DrNotThatEvil/nevil_sbc/hardware/nevil_sbc_rev0/nevil_sbc_rev0.kicad_pcb

## KiCad design hardware/nevil_sbc_rev0/nevil_sbc_rev0.kicad_pcb (2022-11-04)

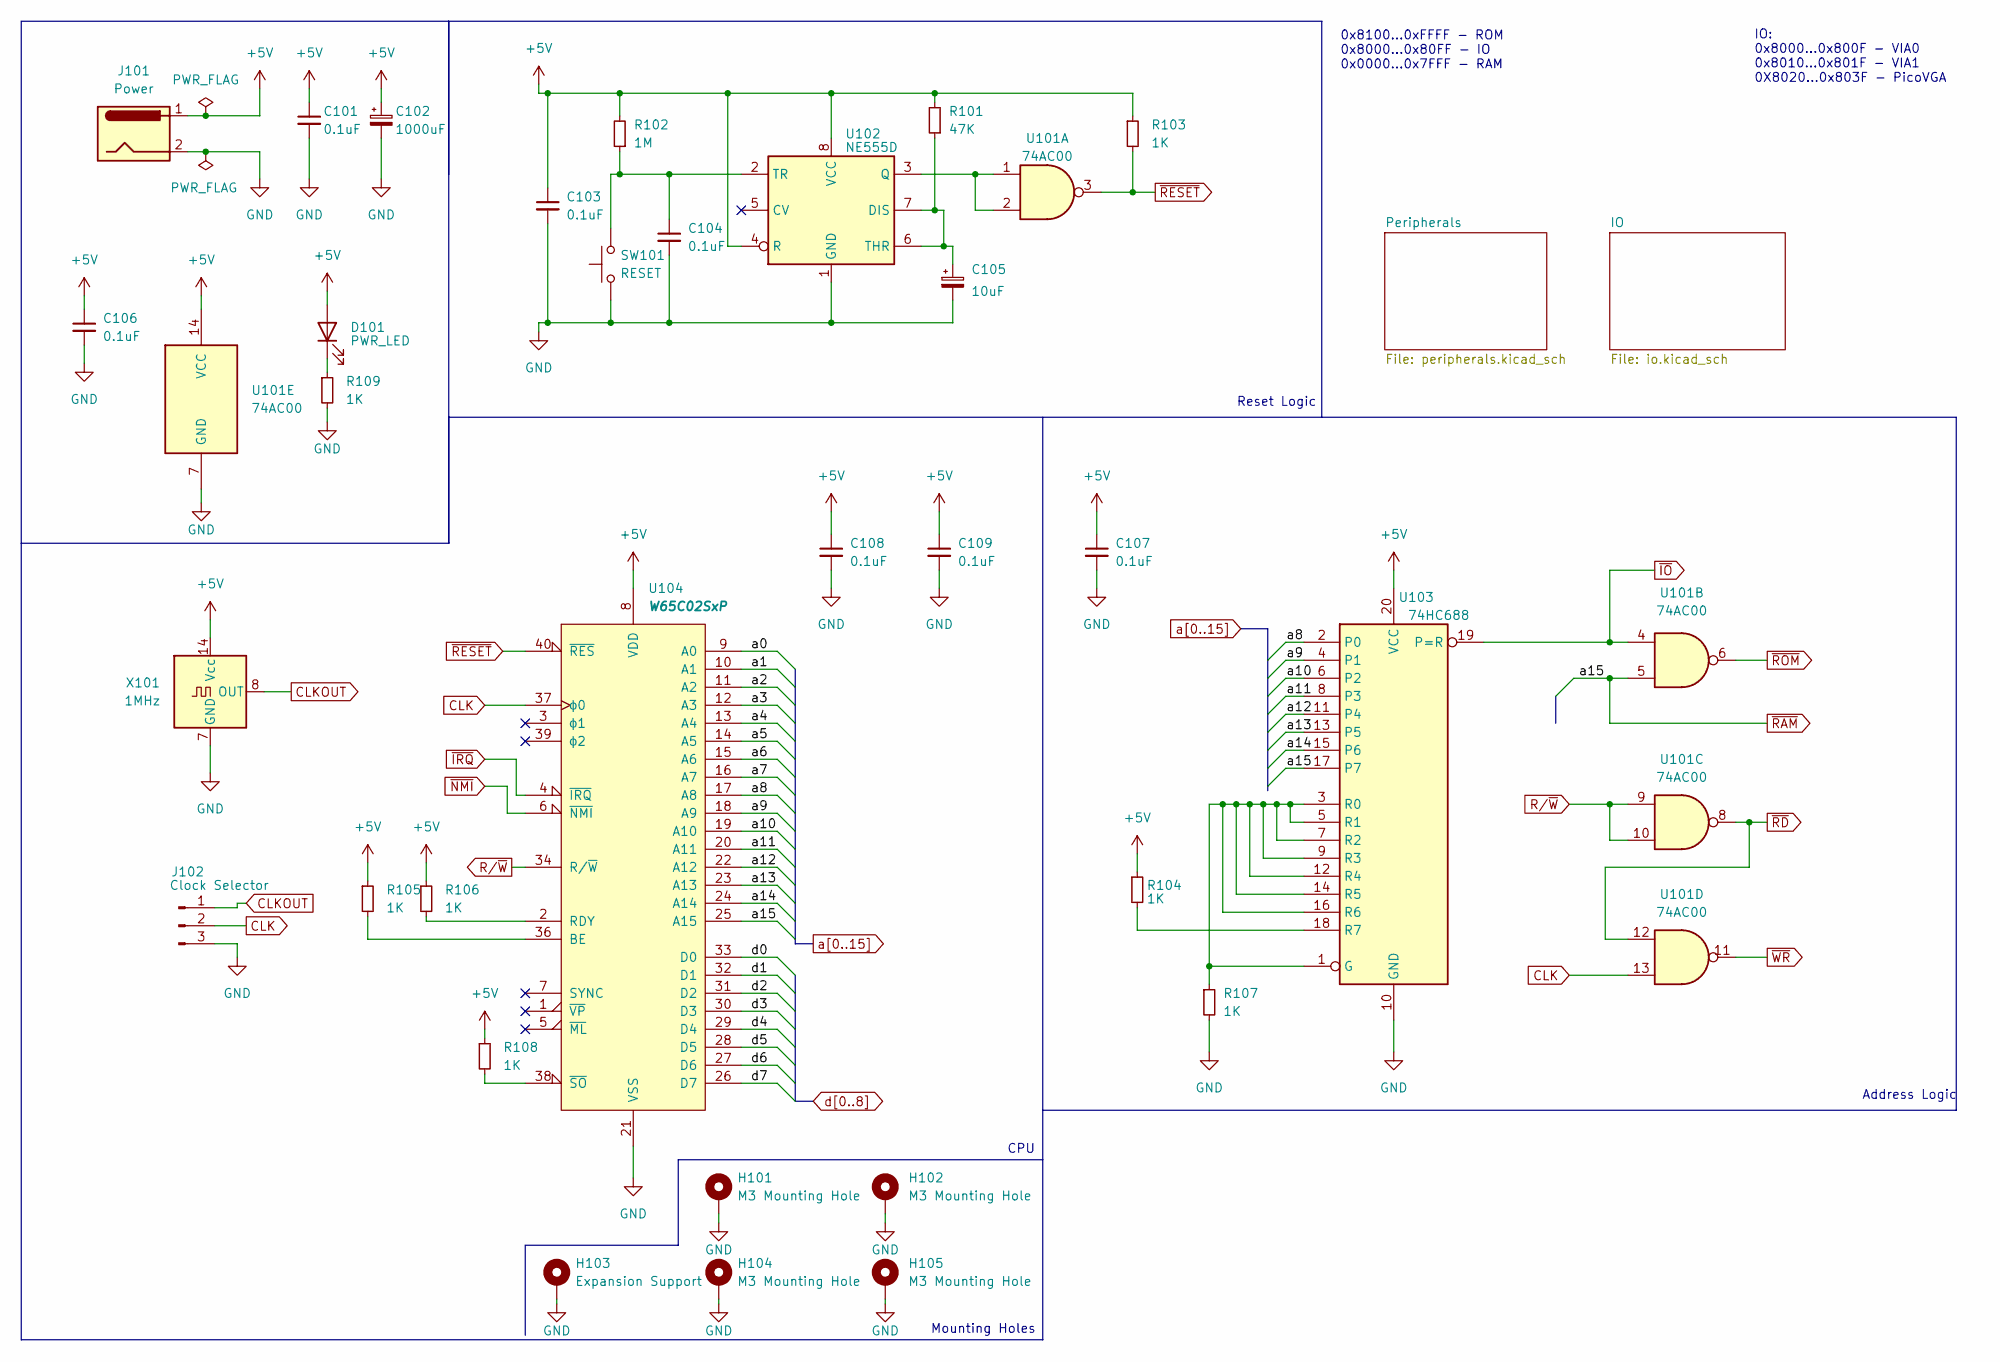
[picture p1: schematic nevil_sbc_rev0.kicad_sch]

Parts:
C101, C103, C104, C106, C107, C108, C109: 0.1uF; C_Disc_D5.0mm_W2.5mm_P5.00mm
C102: 1000uF; CP_Radial_D10.0mm_P5.00mm
C105: 10uF; CP_Radial_D5.0mm_P2.00mm
D101: PWR_LED; LED_D3.0mm
H101, H102, H104, H105: M3 Mounting Hole; MountingHole_3.2mm_M3_Pad
H103: Expansion Support; MountingHole_3.2mm_M3_Pad
J101: Power; C9743-CCRNB001R
J102: Clock Selector; PinHeader_1x03_P2.54mm_Vertical
R101: 47K; R_Axial_DIN0204_L3.6mm_D1.6mm_P7.62mm_Horizontal
R102: 1M; R_Axial_DIN0204_L3.6mm_D1.6mm_P7.62mm_Horizontal
R103, R104, R105, R106, R107, R108, R109: 1K; R_Axial_DIN0204_L3.6mm_D1.6mm_P7.62mm_Horizontal
SW101: RESET; SW_PUSH_6mm
U101: 74AC00; DIP-14_W7.62mm_Socket_LongPads
U102: NE555D; SO-8_5.3x6.2mm_P1.27mm
U103: 74HC688; DIP-20_W7.62mm_Socket_LongPads
U104: W65C02SxP; DIP-40_W15.24mm_Socket_LongPads
X101: 1MHz; DIP-14_W7.62mm_Socket_LongPads

Connections:
+5V: C101.1, C102.1, C103.1, C106.1, C107.1, C108.1, C109.1, D101.2 (A), J101.1, R101.2, R102.2, R103.1, R104.1, R105.1, R106.1, R108.1, U101.14 (VCC), U102.4 (R), U102.8 (VCC), U103.20 (VCC), U104.8 (VDD), X101.14 (Vcc); also elsewhere on the board
CLK: J102.2, U101.13, U104.37 (ϕ0); also elsewhere on the board
CLKOUT: J102.1, X101.8 (OUT)
GND: C101.2, C102.2, C103.2, C104.2, C105.2, C106.2, C107.2, C108.2, C109.2, H101.1, H102.1, H103.1, H104.1, H105.1, J101.2, J102.3, R107.2, R109.2, SW101.1, U101.7 (GND), U102.1 (GND), U103.10 (GND), U104.21 (VSS), X101.7 (GND); also elsewhere on the board
unnamed: C104.1, R102.1, SW101.2, U102.2 (TR)
unnamed: C105.1, R101.1, U102.6 (THR), U102.7 (DIS)
unnamed: D101.1 (K), R109.1
unnamed: R104.2, U103.18 (R7)
unnamed: R105.2, U104.36 (BE)
unnamed: R106.2, U104.2 (RDY)
unnamed: R107.1, U103.1 (G), U103.3 (R0), U103.5 (R1), U103.7 (R2), U103.9 (R3), U103.12 (R4), U103.14 (R5), U103.16 (R6)
unnamed: R108.2, U104.38 (~SO)
unnamed: U101.1, U101.2, U102.3 (Q)
R/~W: U101.9, U101.10, U104.34 (R/~W); also elsewhere on the board
a0: U104.9 (A0); also elsewhere on the board
a1: U104.10 (A1); also elsewhere on the board
a2: U104.11 (A2); also elsewhere on the board
a3: U104.12 (A3); also elsewhere on the board
a4: U104.13 (A4); also elsewhere on the board
a5: U104.14 (A5); also elsewhere on the board
a6: U104.15 (A6); also elsewhere on the board
a7: U104.16 (A7); also elsewhere on the board
a8: U103.2 (P0), U104.17 (A8); also elsewhere on the board
a9: U103.4 (P1), U104.18 (A9); also elsewhere on the board
a10: U103.6 (P2), U104.19 (A10); also elsewhere on the board
a11: U103.8 (P3), U104.20 (A11); also elsewhere on the board
a12: U103.11 (P4), U104.22 (A12); also elsewhere on the board
a13: U103.13 (P5), U104.23 (A13); also elsewhere on the board
a14: U103.15 (P6), U104.24 (A14); also elsewhere on the board
d0: U104.33 (D0); also elsewhere on the board
d1: U104.32 (D1); also elsewhere on the board
d2: U104.31 (D2); also elsewhere on the board
d3: U104.30 (D3); also elsewhere on the board
d4: U104.29 (D4); also elsewhere on the board
d5: U104.28 (D5); also elsewhere on the board
d6: U104.27 (D6); also elsewhere on the board
d7: U104.26 (D7); also elsewhere on the board
~IO: U101.4, U103.19 (P=R); also elsewhere on the board
~IRQ: U104.4 (~IRQ); also elsewhere on the board
~NMI: U104.6 (~NMI)
~RAM: U101.5, U103.17 (P7), U104.25 (A15); also elsewhere on the board
~RD: U101.8, U101.12; also elsewhere on the board
~RESET: R103.2, U101.3, U104.40 (~RES); also elsewhere on the board
~ROM: U101.6; also elsewhere on the board
~WR: U101.11; also elsewhere on the board

Notes on the sheet:
CPU
Address Logic
Reset Logic
0x8100...0xFFFF - ROM 0x8000...0x80FF - IO 0x0000...0x7FFF - RAM
IO: 0x8000...0x800F - VIA0 0x8010...0x801F - VIA1 0X8020...0x803F - PicoVGA
Mounting Holes

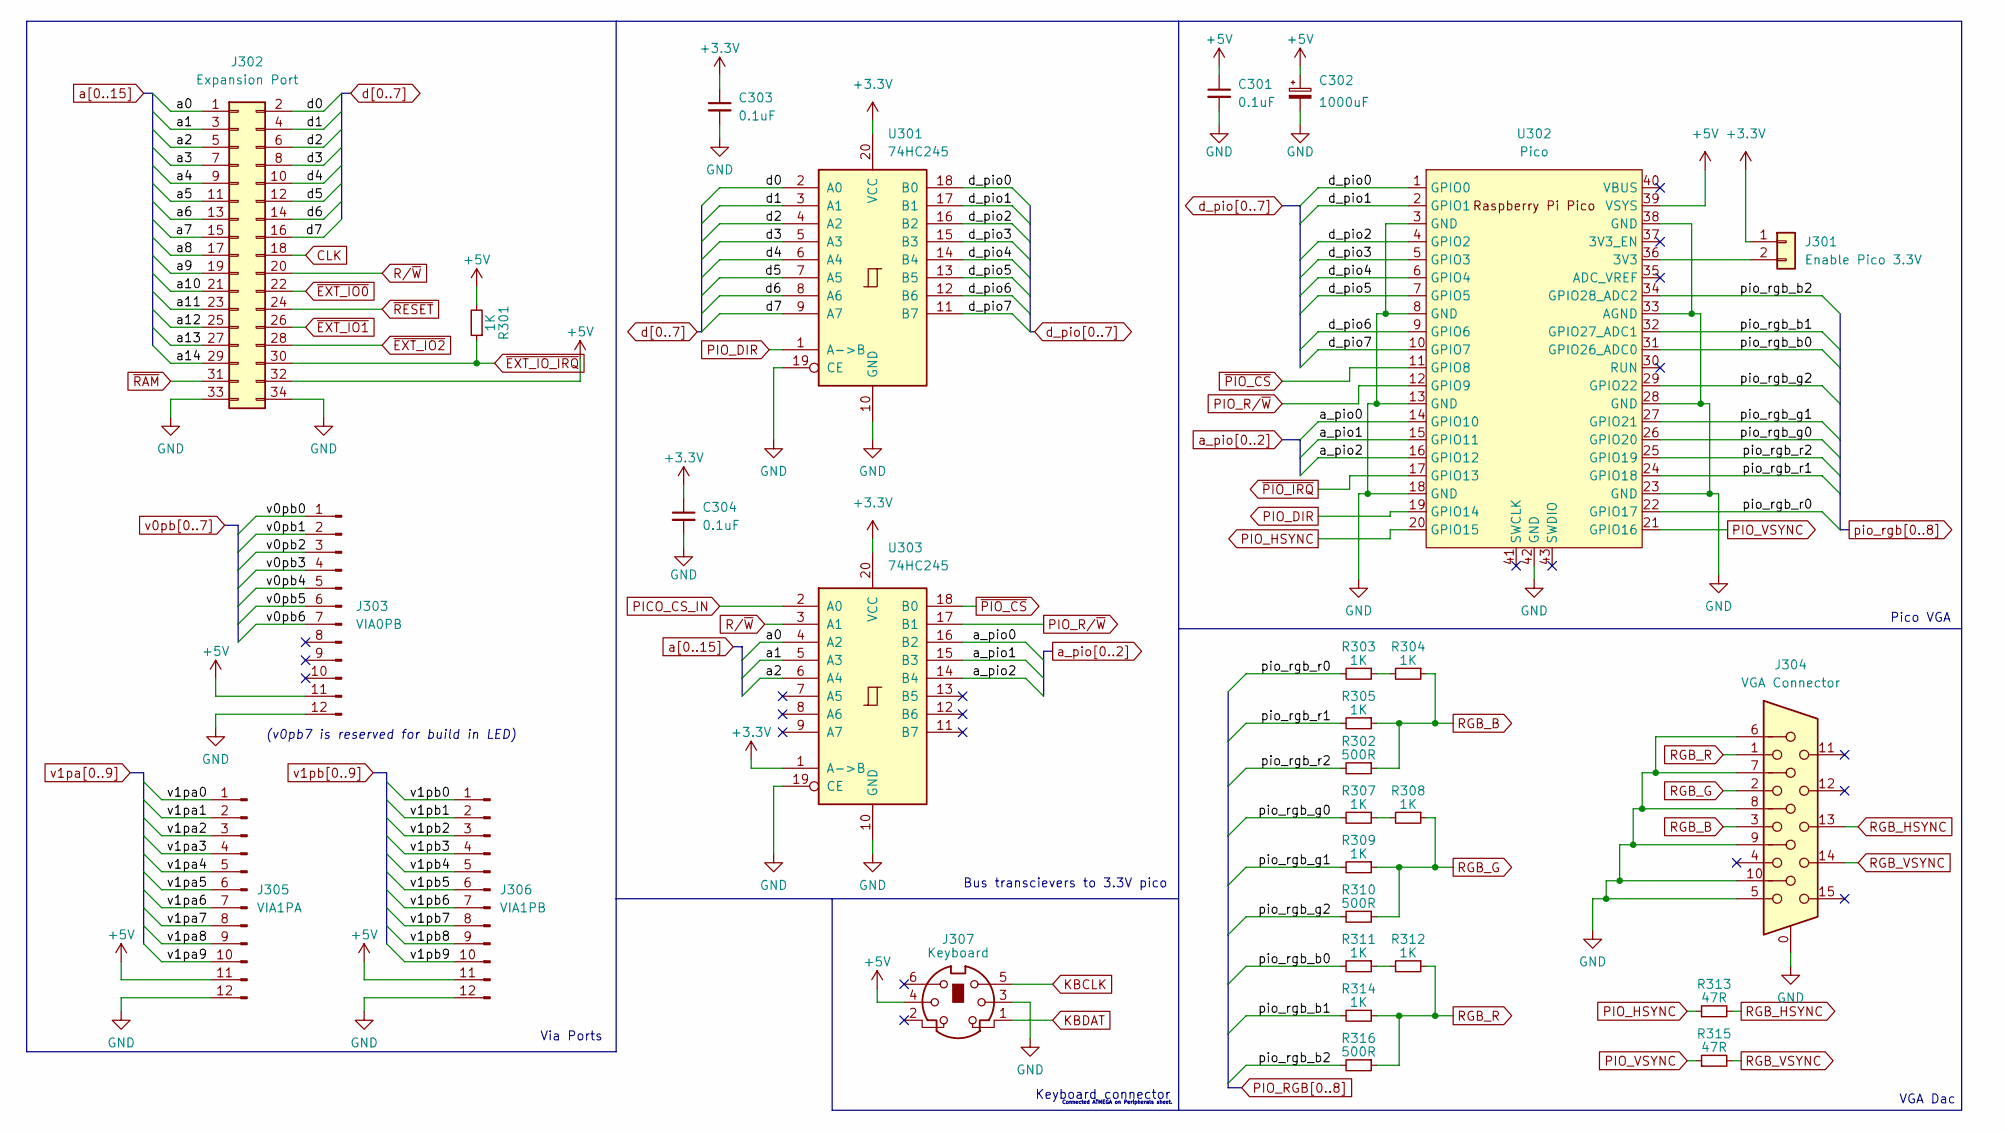
[picture p2: schematic io.kicad_sch]

Parts:
C301, C303, C304: 0.1uF; C_Disc_D5.0mm_W2.5mm_P5.00mm
C302: 1000uF; CP_Radial_D10.0mm_P5.00mm
J301: Enable Pico 3.3V; PinHeader_1x02_P2.54mm_Vertical
J302: Expansion Port; PinHeader_2x17_P2.54mm_Vertical
J303: VIA0PB; PinHeader_1x12_P2.54mm_Vertical
J304: VGA Connector; DSUB-15-HD_Female_Horizontal_P2.29x1.98mm_EdgePinOffset8.35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
J305: VIA1PA; PinHeader_1x12_P2.54mm_Vertical
J306: VIA1PB; PinHeader_1x12_P2.54mm_Vertical
J307: Keyboard; TM 0508 A_6
R301, R303, R304, R305, R307, R308, R309, R311, R312, R314: 1K; R_Axial_DIN0204_L3.6mm_D1.6mm_P7.62mm_Horizontal
R302, R310, R316: 500R; R_Axial_DIN0204_L3.6mm_D1.6mm_P7.62mm_Horizontal
R313, R315: 47R; R_Axial_DIN0204_L3.6mm_D1.6mm_P7.62mm_Horizontal
U301, U303: 74HC245; DIP-20_W7.62mm_Socket_LongPads
U302: Pico; RPi_Pico_SMD_TH

Connections:
+3.3V: C303.1, C304.1, J301.1, U301.20 (VCC), U303.1 (A->B), U303.20 (VCC)
+5V: C301.1, C302.1, J302.32, J303.11, J305.11, J306.11, J307.4, R301.2, U302.39 (VSYS); also elsewhere on the board
/IO/pio_rgb_b0: R311.2, U302.31 (GPIO26_ADC0)
/IO/pio_rgb_b1: R314.2, U302.32 (GPIO27_ADC1)
/IO/pio_rgb_b2: R316.2, U302.34 (GPIO28_ADC2)
/IO/pio_rgb_g0: R307.2, U302.26 (GPIO20)
/IO/pio_rgb_g1: R309.2, U302.27 (GPIO21)
/IO/pio_rgb_g2: R310.2, U302.29 (GPIO22)
/IO/pio_rgb_r0: R303.2, U302.22 (GPIO17)
/IO/pio_rgb_r1: R305.2, U302.24 (GPIO18)
/IO/pio_rgb_r2: R302.2, U302.25 (GPIO19)
CLK: J302.18; also elsewhere on the board
GND: C301.2, C302.2, C303.2, C304.2, J302.33, J302.34, J303.12, J304.0, J304.5, J304.6, J304.7, J304.8, J304.9, J304.10, J305.12, J306.12, J307.3, U301.10 (GND), U301.19 (CE), U302.3 (GND), U302.8 (GND), U302.13 (GND), U302.18 (GND), U302.23 (GND), U302.28 (GND), U302.33 (AGND), U302.38 (GND), U302.42 (GND), U303.10 (GND), U303.19 (CE); also elsewhere on the board
KBCLK: J307.5; also elsewhere on the board
KBDAT: J307.1; also elsewhere on the board
unnamed: J301.2, U302.36 (3V3)
unnamed: R303.1, R304.2
unnamed: R307.1, R308.2
unnamed: R311.1, R312.2
PICO_CS_IN: U303.2 (A0); also elsewhere on the board
PIO_DIR: U301.1 (A->B), U302.19 (GPIO14)
PIO_HSYNC: R313.1, U302.20 (GPIO15)
PIO_R/~W: U302.12 (GPIO9), U303.17 (B1)
PIO_VSYNC: R315.1, U302.21 (GPIO16)
RGB_B: J304.3, R302.1, R304.1, R305.1
RGB_G: J304.2, R308.1, R309.1, R310.1
RGB_HSYNC: J304.13, R313.2
RGB_R: J304.1, R312.1, R314.1, R316.1
RGB_VSYNC: J304.14, R315.2
R/~W: J302.20, U303.3 (A1); also elsewhere on the board
a0: J302.1, U303.4 (A2); also elsewhere on the board
a1: J302.3, U303.5 (A3); also elsewhere on the board
a2: J302.5, U303.6 (A4); also elsewhere on the board
a3: J302.7; also elsewhere on the board
a4: J302.9; also elsewhere on the board
a5: J302.11; also elsewhere on the board
a6: J302.13; also elsewhere on the board
a7: J302.15; also elsewhere on the board
a8: J302.17; also elsewhere on the board
a9: J302.19; also elsewhere on the board
a10: J302.21; also elsewhere on the board
a11: J302.23; also elsewhere on the board
a12: J302.25; also elsewhere on the board
a13: J302.27; also elsewhere on the board
a14: J302.29; also elsewhere on the board
a_pio0: U302.14 (GPIO10), U303.16 (B2)
a_pio1: U302.15 (GPIO11), U303.15 (B3)
a_pio2: U302.16 (GPIO12), U303.14 (B4)
d0: J302.2, U301.2 (A0); also elsewhere on the board
d1: J302.4, U301.3 (A1); also elsewhere on the board
d2: J302.6, U301.4 (A2); also elsewhere on the board
d3: J302.8, U301.5 (A3); also elsewhere on the board
d4: J302.10, U301.6 (A4); also elsewhere on the board
d5: J302.12, U301.7 (A5); also elsewhere on the board
d6: J302.14, U301.8 (A6); also elsewhere on the board
d7: J302.16, U301.9 (A7); also elsewhere on the board
d_pio0: U301.18 (B0), U302.1 (GPIO0)
d_pio1: U301.17 (B1), U302.2 (GPIO1)
d_pio2: U301.16 (B2), U302.4 (GPIO2)
d_pio3: U301.15 (B3), U302.5 (GPIO3)
d_pio4: U301.14 (B4), U302.6 (GPIO4)
d_pio5: U301.13 (B5), U302.7 (GPIO5)
d_pio6: U301.12 (B6), U302.9 (GPIO6)
d_pio7: U301.11 (B7), U302.10 (GPIO7)
v0pb0: J303.1; also elsewhere on the board
v0pb1: J303.2; also elsewhere on the board
v0pb2: J303.3; also elsewhere on the board
v0pb3: J303.4; also elsewhere on the board
v0pb4: J303.5; also elsewhere on the board
v0pb5: J303.6; also elsewhere on the board
v0pb6: J303.7; also elsewhere on the board
v1pa0: J305.1; also elsewhere on the board
v1pa1: J305.2; also elsewhere on the board
v1pa2: J305.3; also elsewhere on the board
v1pa3: J305.4; also elsewhere on the board
v1pa4: J305.5; also elsewhere on the board
v1pa5: J305.6; also elsewhere on the board
v1pa6: J305.7; also elsewhere on the board
v1pa7: J305.8; also elsewhere on the board
v1pa8: J305.9; also elsewhere on the board
v1pa9: J305.10; also elsewhere on the board
v1pb0: J306.1; also elsewhere on the board
v1pb1: J306.2; also elsewhere on the board
v1pb2: J306.3; also elsewhere on the board
v1pb3: J306.4; also elsewhere on the board
v1pb4: J306.5; also elsewhere on the board
v1pb5: J306.6; also elsewhere on the board
v1pb6: J306.7; also elsewhere on the board
v1pb7: J306.8; also elsewhere on the board
v1pb8: J306.9; also elsewhere on the board
v1pb9: J306.10; also elsewhere on the board
~EXT_IO0: J302.22; also elsewhere on the board
~EXT_IO1: J302.26; also elsewhere on the board
~EXT_IO2: J302.28; also elsewhere on the board
~EXT_IO_IRQ: J302.30, R301.1; also elsewhere on the board
~PIO_CS: U302.11 (GPIO8), U303.18 (B0)
~PIO_IRQ: U302.17 (GPIO13)
~RAM: J302.31; also elsewhere on the board
~RESET: J302.24; also elsewhere on the board

Notes on the sheet:
Bus transcievers to 3.3V pico
VGA Dac
Connected ATMEGA on Peripherals sheet.
Via Ports
Keyboard connector
Pico VGA
(v0pb7 is reserved for build in LED)

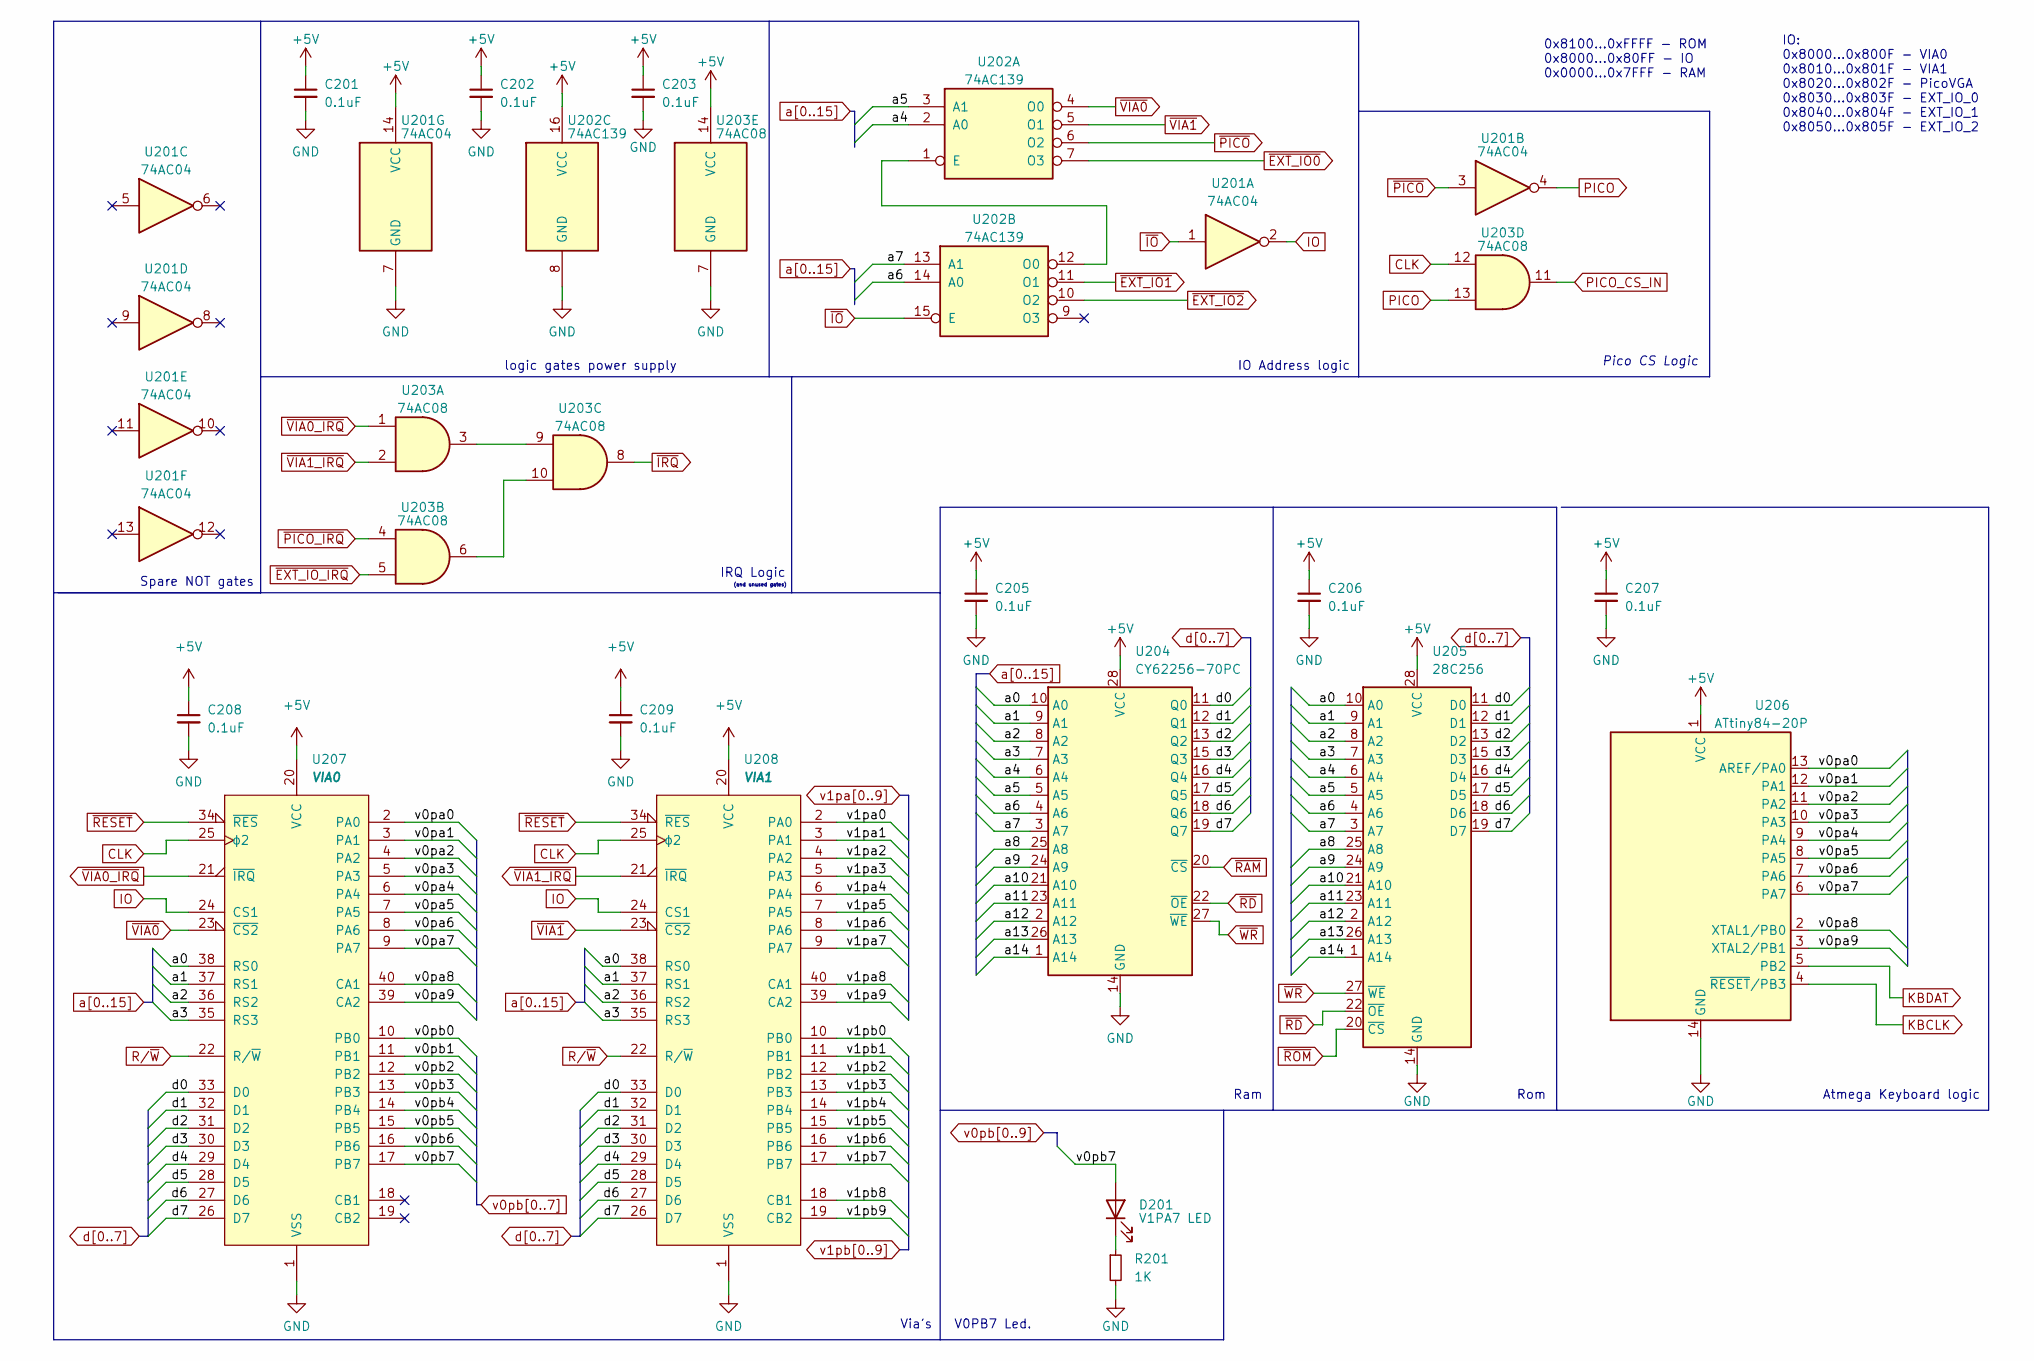
[picture p3: schematic peripherals.kicad_sch]

Parts:
C201, C202, C203, C205, C206, C207, C208, C209: 0.1uF; C_Disc_D5.0mm_W2.5mm_P5.00mm
D201: V1PA7 LED; LED_D3.0mm
R201: 1K; R_Axial_DIN0204_L3.6mm_D1.6mm_P7.62mm_Horizontal
U201: 74AC04; DIP-14_W7.62mm_Socket_LongPads
U202: 74AC139; TSSOP-16_4.4x5mm_P0.65mm
U203: 74AC08; DIP-14_W7.62mm_Socket_LongPads
U204: CY62256-70PC; DIP-28_W15.24mm_Socket_LongPads
U205: 28C256; DIP-28_W15.24mm_Socket_LongPads
U206: ATtiny84-20P; DIP-14_W7.62mm
U207: VIA0; DIP-40_W15.24mm_Socket_LongPads
U208: VIA1; DIP-40_W15.24mm_Socket_LongPads

Connections:
+5V: C201.1, C202.1, C203.1, C205.1, C206.1, C207.1, C208.1, C209.1, U201.14 (VCC), U202.16 (VCC), U203.14 (VCC), U204.28 (VCC), U205.28 (VCC), U206.1 (VCC), U207.20 (VCC), U208.20 (VCC); also elsewhere on the board
/Peripherals/v0pa0: U206.13 (AREF/PA0), U207.2 (PA0)
/Peripherals/v0pa1: U206.12 (PA1), U207.3 (PA1)
/Peripherals/v0pa2: U206.11 (PA2), U207.4 (PA2)
/Peripherals/v0pa3: U206.10 (PA3), U207.5 (PA3)
/Peripherals/v0pa4: U206.9 (PA4), U207.6 (PA4)
/Peripherals/v0pa5: U206.8 (PA5), U207.7 (PA5)
/Peripherals/v0pa6: U206.7 (PA6), U207.8 (PA6)
/Peripherals/v0pa7: U206.6 (PA7), U207.9 (PA7)
/Peripherals/v0pa8: U206.2 (XTAL1/PB0), U207.40 (CA1)
/Peripherals/v0pa9: U206.3 (XTAL2/PB1), U207.39 (CA2)
CLK: U203.12, U207.25 (ϕ2), U208.25 (ϕ2); also elsewhere on the board
GND: C201.2, C202.2, C203.2, C205.2, C206.2, C207.2, C208.2, C209.2, R201.2, U201.7 (GND), U202.8 (GND), U203.7 (GND), U204.14 (GND), U205.14 (GND), U206.14 (GND), U207.1 (VSS), U208.1 (VSS); also elsewhere on the board
IO: U201.2, U207.24 (CS1), U208.24 (CS1)
KBCLK: U206.4 (~RESET/PB3); also elsewhere on the board
KBDAT: U206.5 (PB2); also elsewhere on the board
unnamed: D201.1 (K), R201.1
unnamed: U202.1 (E), U202.12 (O0)
unnamed: U203.3, U203.9
unnamed: U203.6, U203.10
PICO: U201.4, U203.13
PICO_CS_IN: U203.11; also elsewhere on the board
R/~W: U207.22 (R/~W), U208.22 (R/~W); also elsewhere on the board
a0: U204.10 (A0), U205.10 (A0), U207.38 (RS0), U208.38 (RS0); also elsewhere on the board
a1: U204.9 (A1), U205.9 (A1), U207.37 (RS1), U208.37 (RS1); also elsewhere on the board
a2: U204.8 (A2), U205.8 (A2), U207.36 (RS2), U208.36 (RS2); also elsewhere on the board
a3: U204.7 (A3), U205.7 (A3), U207.35 (RS3), U208.35 (RS3); also elsewhere on the board
a4: U202.2 (A0), U204.6 (A4), U205.6 (A4); also elsewhere on the board
a5: U202.3 (A1), U204.5 (A5), U205.5 (A5); also elsewhere on the board
a6: U202.14 (A0), U204.4 (A6), U205.4 (A6); also elsewhere on the board
a7: U202.13 (A1), U204.3 (A7), U205.3 (A7); also elsewhere on the board
a8: U204.25 (A8), U205.25 (A8); also elsewhere on the board
a9: U204.24 (A9), U205.24 (A9); also elsewhere on the board
a10: U204.21 (A10), U205.21 (A10); also elsewhere on the board
a11: U204.23 (A11), U205.23 (A11); also elsewhere on the board
a12: U204.2 (A12), U205.2 (A12); also elsewhere on the board
a13: U204.26 (A13), U205.26 (A13); also elsewhere on the board
a14: U204.1 (A14), U205.1 (A14); also elsewhere on the board
d0: U204.11 (Q0), U205.11 (D0), U207.33 (D0), U208.33 (D0); also elsewhere on the board
d1: U204.12 (Q1), U205.12 (D1), U207.32 (D1), U208.32 (D1); also elsewhere on the board
d2: U204.13 (Q2), U205.13 (D2), U207.31 (D2), U208.31 (D2); also elsewhere on the board
d3: U204.15 (Q3), U205.15 (D3), U207.30 (D3), U208.30 (D3); also elsewhere on the board
d4: U204.16 (Q4), U205.16 (D4), U207.29 (D4), U208.29 (D4); also elsewhere on the board
d5: U204.17 (Q5), U205.17 (D5), U207.28 (D5), U208.28 (D5); also elsewhere on the board
d6: U204.18 (Q6), U205.18 (D6), U207.27 (D6), U208.27 (D6); also elsewhere on the board
d7: U204.19 (Q7), U205.19 (D7), U207.26 (D7), U208.26 (D7); also elsewhere on the board
v0pb0: U207.10 (PB0); also elsewhere on the board
v0pb1: U207.11 (PB1); also elsewhere on the board
v0pb2: U207.12 (PB2); also elsewhere on the board
v0pb3: U207.13 (PB3); also elsewhere on the board
v0pb4: U207.14 (PB4); also elsewhere on the board
v0pb5: U207.15 (PB5); also elsewhere on the board
v0pb6: U207.16 (PB6); also elsewhere on the board
v0pb7: D201.2 (A), U207.17 (PB7)
v1pa0: U208.2 (PA0); also elsewhere on the board
v1pa1: U208.3 (PA1); also elsewhere on the board
v1pa2: U208.4 (PA2); also elsewhere on the board
v1pa3: U208.5 (PA3); also elsewhere on the board
v1pa4: U208.6 (PA4); also elsewhere on the board
v1pa5: U208.7 (PA5); also elsewhere on the board
v1pa6: U208.8 (PA6); also elsewhere on the board
v1pa7: U208.9 (PA7); also elsewhere on the board
v1pa8: U208.40 (CA1); also elsewhere on the board
v1pa9: U208.39 (CA2); also elsewhere on the board
v1pb0: U208.10 (PB0); also elsewhere on the board
v1pb1: U208.11 (PB1); also elsewhere on the board
v1pb2: U208.12 (PB2); also elsewhere on the board
v1pb3: U208.13 (PB3); also elsewhere on the board
v1pb4: U208.14 (PB4); also elsewhere on the board
v1pb5: U208.15 (PB5); also elsewhere on the board
v1pb6: U208.16 (PB6); also elsewhere on the board
v1pb7: U208.17 (PB7); also elsewhere on the board
v1pb8: U208.18 (CB1); also elsewhere on the board
v1pb9: U208.19 (CB2); also elsewhere on the board
~EXT_IO0: U202.7 (O3); also elsewhere on the board
~EXT_IO1: U202.11 (O1); also elsewhere on the board
~EXT_IO2: U202.10 (O2); also elsewhere on the board
~EXT_IO_IRQ: U203.5; also elsewhere on the board
~IO: U201.1, U202.15 (E); also elsewhere on the board
~IRQ: U203.8; also elsewhere on the board
~PICO_IRQ: U203.4
~PICO: U201.3, U202.6 (O2)
~RAM: U204.20 (~CS); also elsewhere on the board
~RD: U204.22 (~OE), U205.22 (~OE); also elsewhere on the board
~RESET: U207.34 (~RES), U208.34 (~RES); also elsewhere on the board
~ROM: U205.20 (~CS); also elsewhere on the board
~VIA0_IRQ: U203.1, U207.21 (~IRQ)
~VIA0: U202.4 (O0), U207.23 (~CS2)
~VIA1_IRQ: U203.2, U208.21 (~IRQ)
~VIA1: U202.5 (O1), U208.23 (~CS2)
~WR: U204.27 (~WE), U205.27 (~WE); also elsewhere on the board

Notes on the sheet:
Spare NOT gates
(and unused gates)
logic gates power supply
0x8100...0xFFFF - ROM 0x8000...0x80FF - IO 0x0000...0x7FFF - RAM
Rom
Via's
Pico CS Logic
V0PB7 Led.
Ram
IRQ Logic
IO: 0x8000...0x800F - VIA0 0x8010...0x801F - VIA1 0x8020...0x802F - PicoVGA 0x8030...0x803F - EXT_IO_0 0x8040...0x804F - EXT_IO_1 0x8050...0x805F - EXT_IO_2
Atmega Keyboard logic
IO Address logic

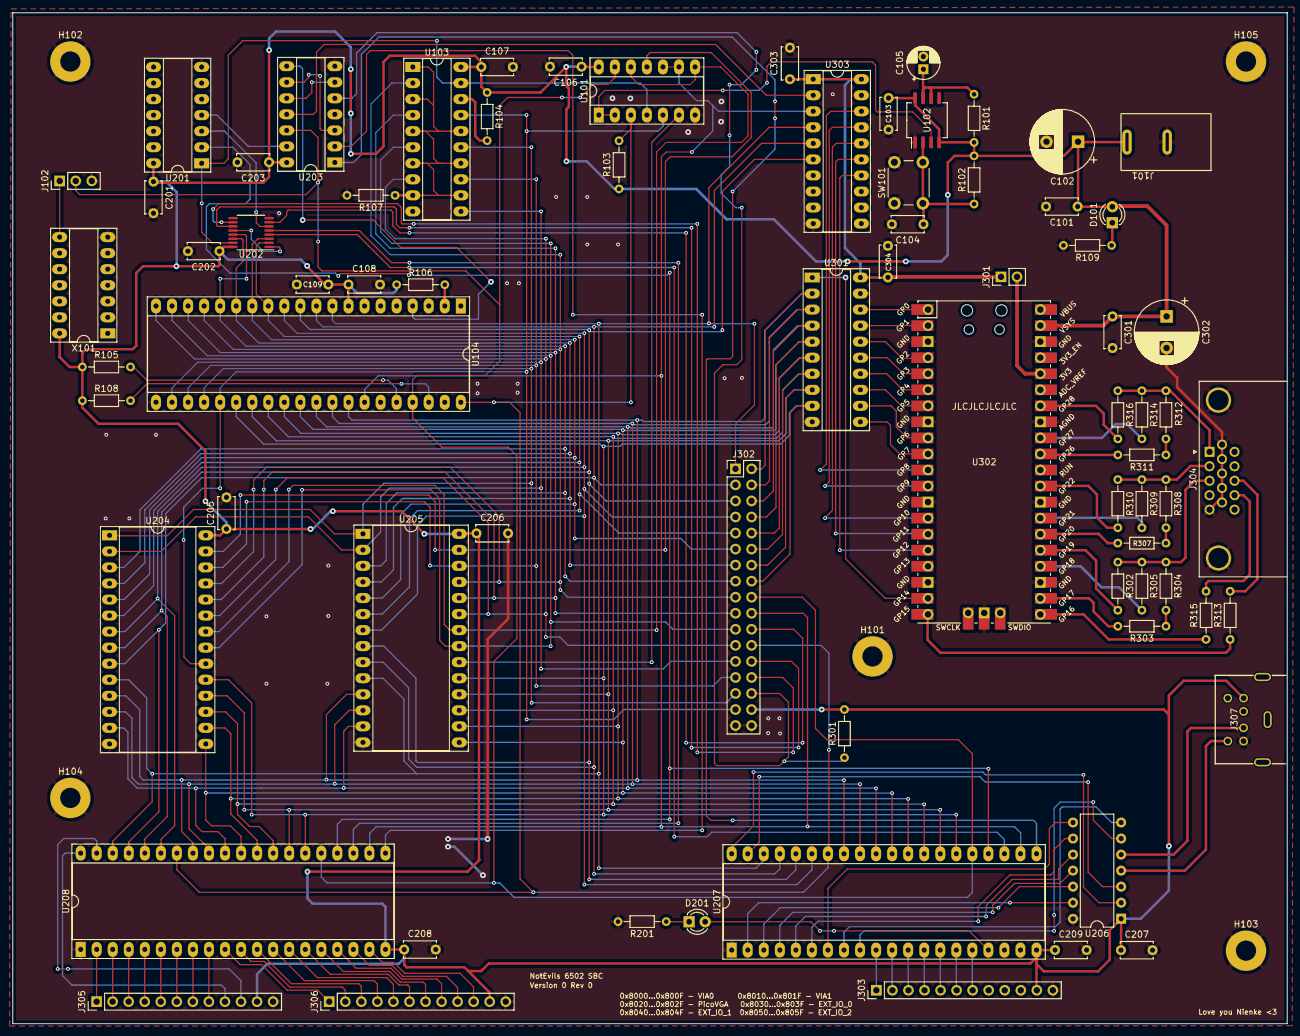
[picture p4: board nevil_sbc_rev0.kicad_pcb from above]

Board: 2 copper layers, 201.8 x 160.0 mm, 79 parts (0 on the bottom side), 135 nets.
