DrNotThatEvil/nevil_sbc/pico_vga/src/test_screen.c

#include "test_screen.h"

const uint8_t default_screen_buffer[12] = {
    0x88, // h
    0x81, // a
    0x8C, // l
    0x8C, // l
    0x8F, // o
    0xA0, // 
    0x97, // w
    0x8F, // o
    0x92, // r
    0x8C, // l
    0x84, // d
    0x60, // flashing space
};
