DrNotThatEvil/nevil_sbc/(commit log)

2022-09-14 Working on base 6502 bus for pico vga
2022-09-23 Hardware schematics
    [nevil_sbc_rev0.kicad_pcb, nevil_sbc_rev0.kicad_sch]
2022-09-25 Updating schematics
    [nevil_sbc_rev0.kicad_sch, peripherals.kicad_sch]
2022-10-06 Stashing work to switch machines
    [nevil_sbc_rev0.kicad_sch, peripherals.kicad_sch]
2022-10-07 Stashing work
    [peripherals.kicad_sch]
2022-10-09 Stashing work to continue on workstation
    [nevil_sbc_rev0.kicad_sch, peripherals.kicad_sch]
2022-10-20 Finsing up peripherals almost done with schematic
    [io.kicad_sch, nevil_sbc_rev0.kicad_sch, peripherals.kicad_sch]
2022-10-22 Finishing base schematic
    [peripherals.kicad_sch]
2022-10-25 Add pcb files and small clk change for pico
    [io.kicad_sch, nevil_sbc_rev0.kicad_pcb, nevil_sbc_rev0.kicad_sch, peripherals.kicad_sch]
2022-10-25 Working on pcb
    [io.kicad_sch, nevil_sbc_rev0.kicad_pcb, nevil_sbc_rev0.kicad_sch]
2022-10-25 Update pcb
    [nevil_sbc_rev0.kicad_pcb]
2022-10-25 Working on PCB address bus
    [nevil_sbc_rev0.kicad_pcb]
2022-11-04 working on vga code
    [io.kicad_sch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]
2022-11-04 Switching to desktop
2022-11-12 Pushing for real pcb work
2022-11-21 Added small txt to keep track of bugs
